awk6873/arduino-Sony_S50CP/worklog/DSC_0122.jpg

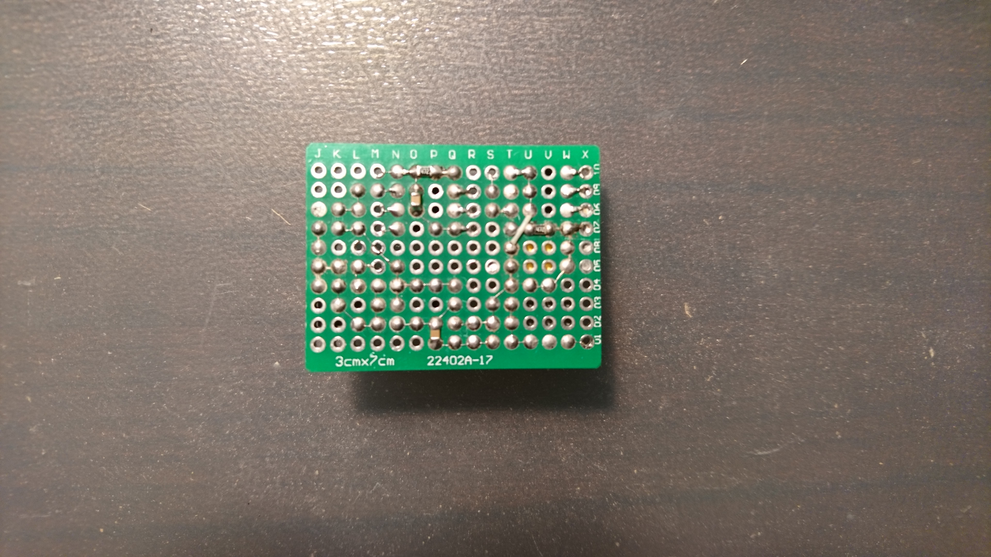
worklog/DSC_0122.jpg
