awk6873/arduino-Sony_S50CP/worklog/1zss50cp.jpg

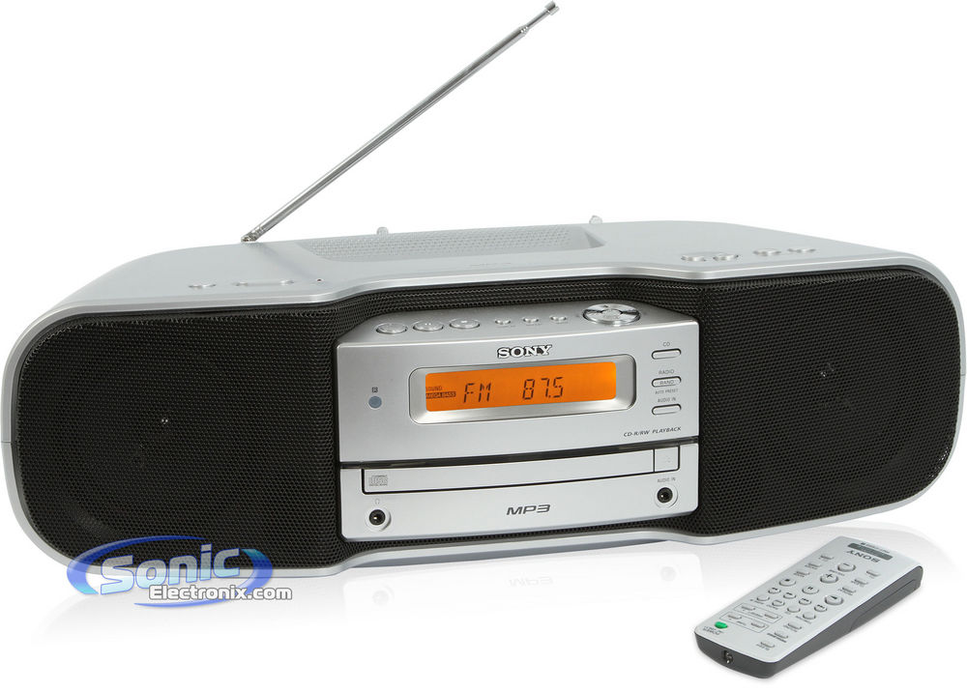
worklog/1zss50cp.jpg
