awk6873/arduino-Sony_S50CP/README.md

# arduino-Sony_S50CP

 Add-on to personal audio system Sony ZS-S50CP 
 - adding enhanced bass and treble adjustment to sound through native RC controller
 - adding bluetooth module KRC-86B to audio-in with remote control through native RC controller

Based on two ATtiny and KRC-86B BT board
