awk6873/arduino-Sony_S50CP/Datasheets/KRC86B_conn.jpg

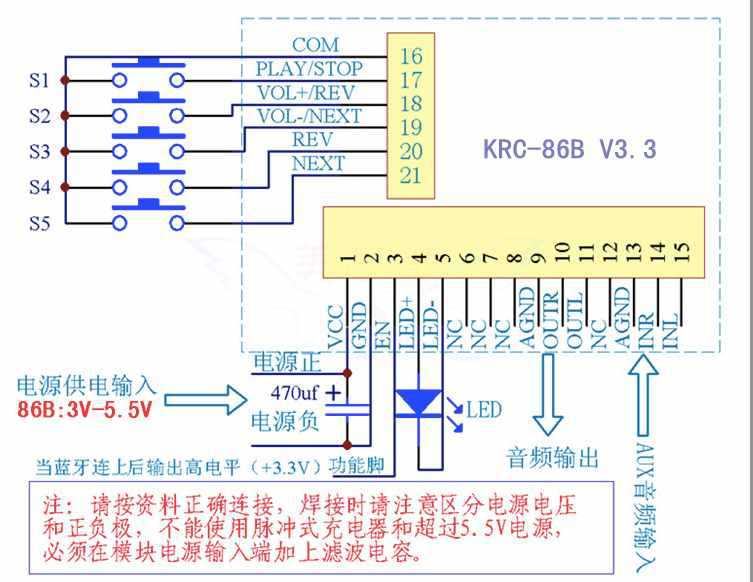
Datasheets/KRC86B_conn.jpg
