awk6873/arduino-Sony_S50CP/Datasheets/KRC86B_pinout.jpg

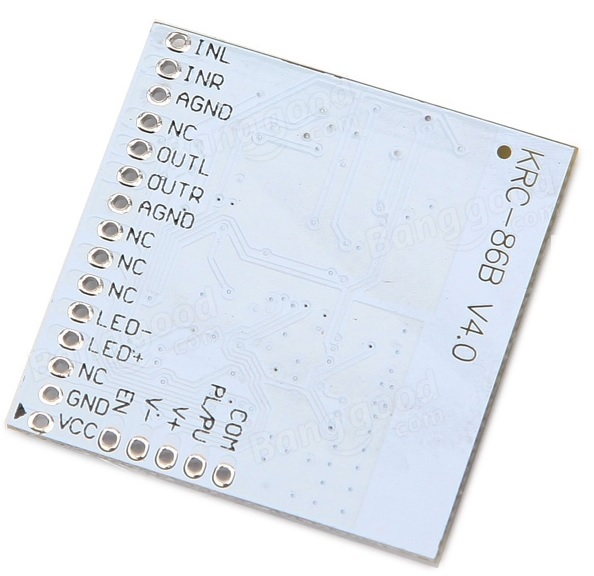
Datasheets/KRC86B_pinout.jpg
