awk6873/arduino-Sony_S50CP/Datasheets/R2S15904SP.jpg

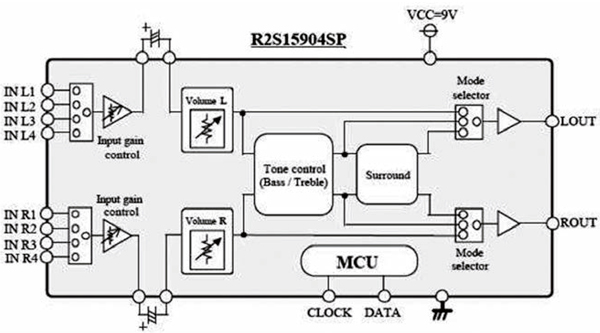
Datasheets/R2S15904SP.jpg
