awk6873/arduino-Sony_S50CP/Datasheets/R2S15904SP_pinout.jpg

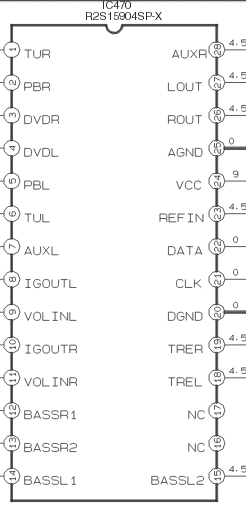
Datasheets/R2S15904SP_pinout.jpg
