awk6873/arduino-Sony_S50CP/LA_diagrams/LA_20180124_Off_1.jpg

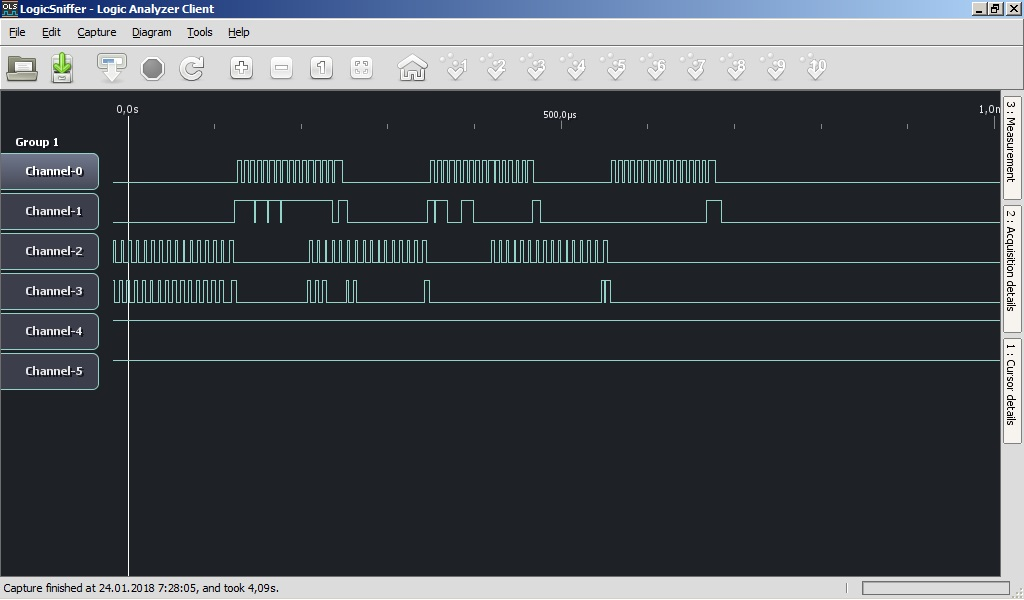
LA_diagrams/LA_20180124_Off_1.jpg
