awk6873/arduino-Sony_S50CP/LA_diagrams/LA_201801122250.jpg

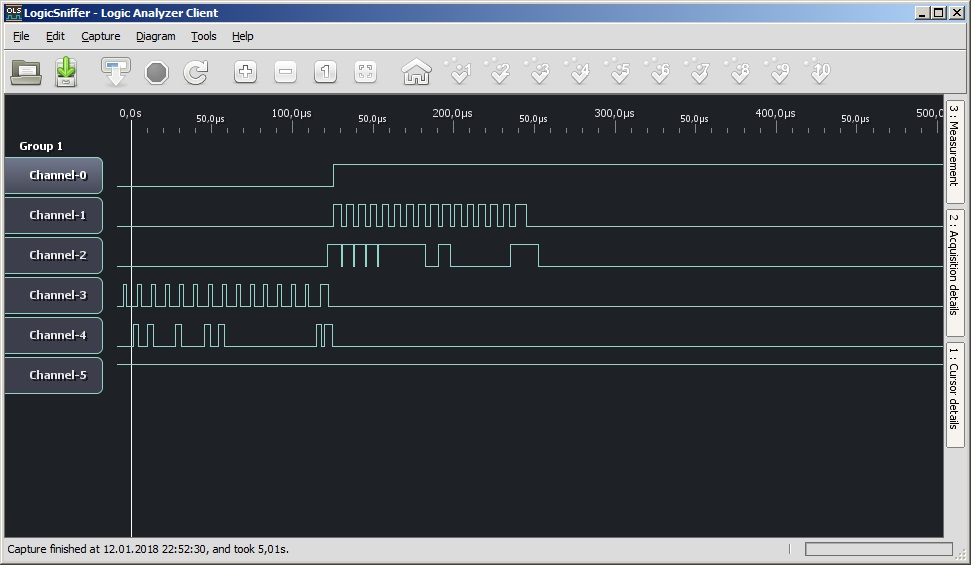
LA_diagrams/LA_201801122250.jpg
