awk6873/arduino-Sony_S50CP/LA_diagrams/LA_201801141800.jpg

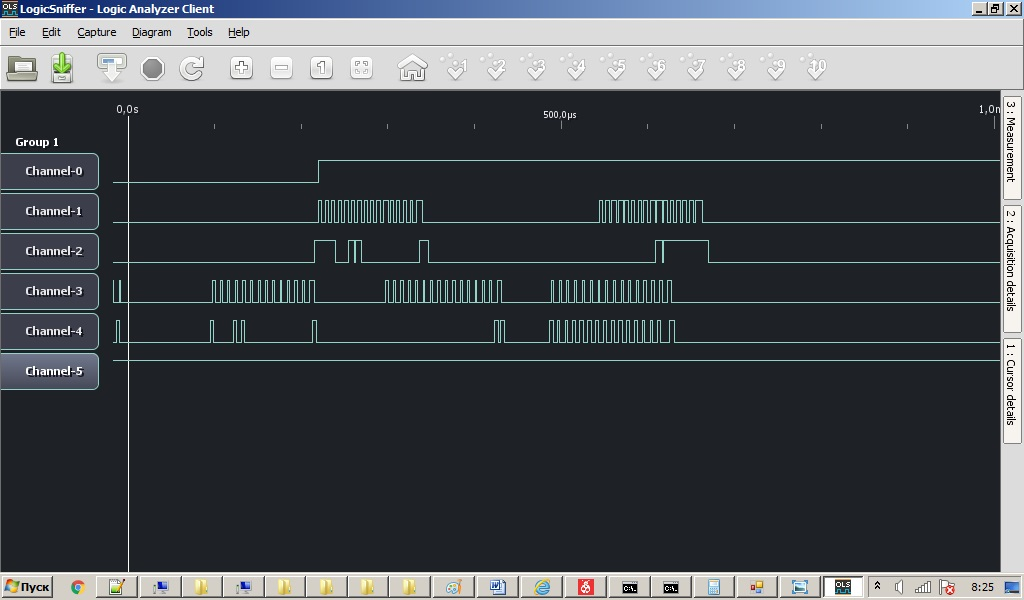
LA_diagrams/LA_201801141800.jpg
