awk6873/arduino-Sony_S50CP/Sony_RC_Play_code.jpg

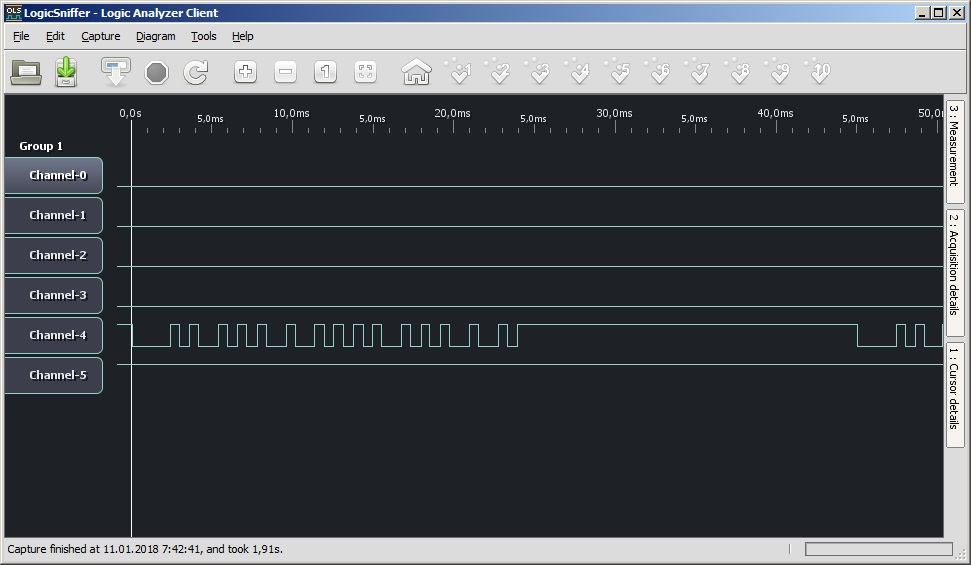
Sony_RC_Play_code.jpg
