awk6873/arduino-Sony_S50CP/Схема.jpg

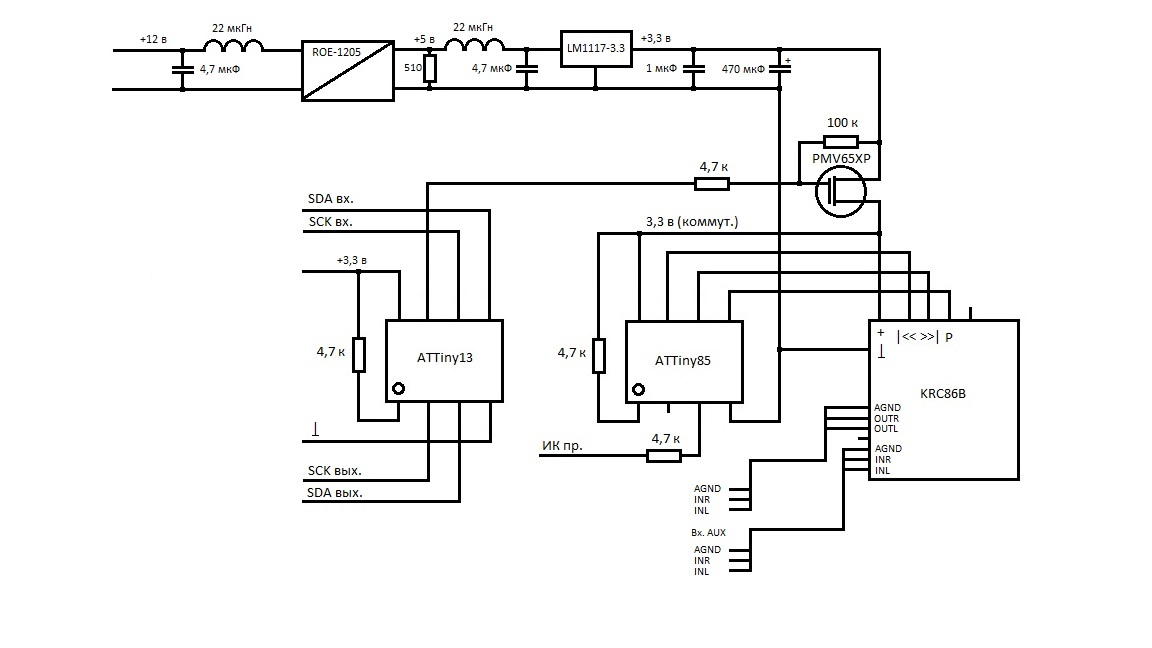
Схема.jpg
