awk6873/arduino-Sony_S50CP/Схема_v2.jpg

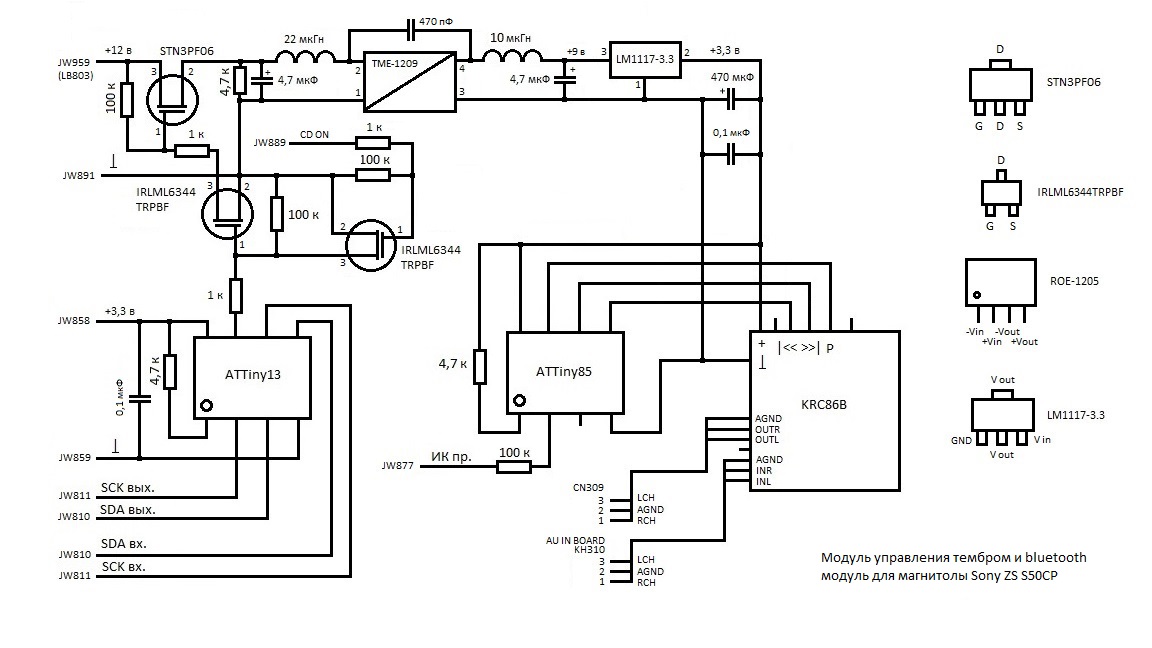
Схема_v2.jpg
