awk6873/arduino-Sony_S50CP/(list of files, cad)

Other CAD files:
Sony_S50CP_Sound.obj
Test1.obj
