awk6873/arduino-Sony_S50CP/worklog/DSC_0045.JPG

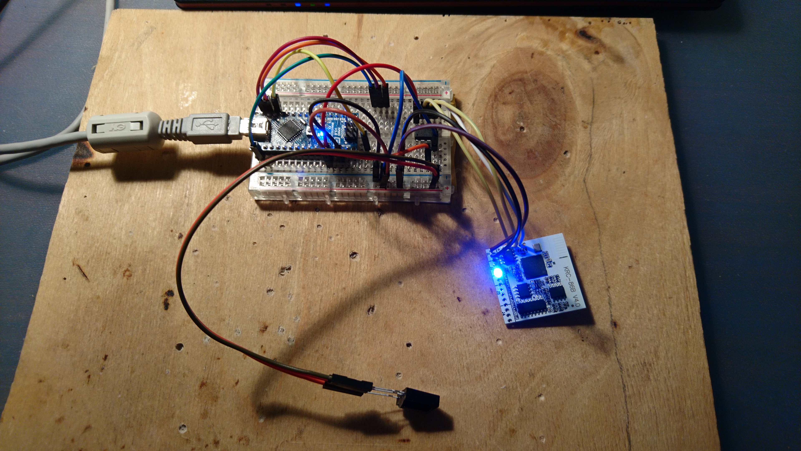
worklog/DSC_0045.JPG
