awk6873/arduino-Sony_S50CP/worklog/DSC_0117.JPG

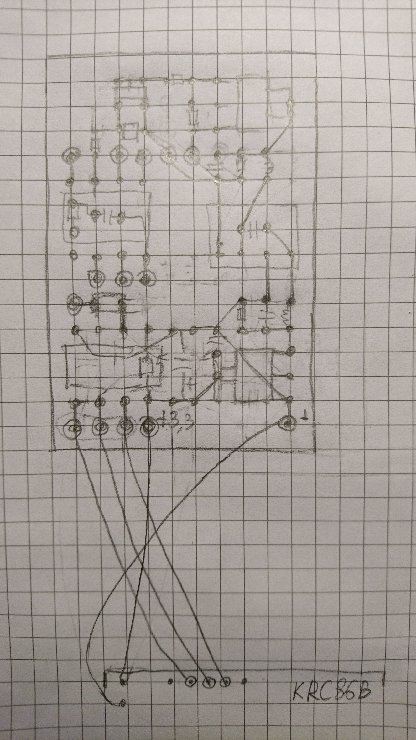
worklog/DSC_0117.JPG
