awk6873/arduino-Sony_S50CP/worklog/DSC_0249.JPG

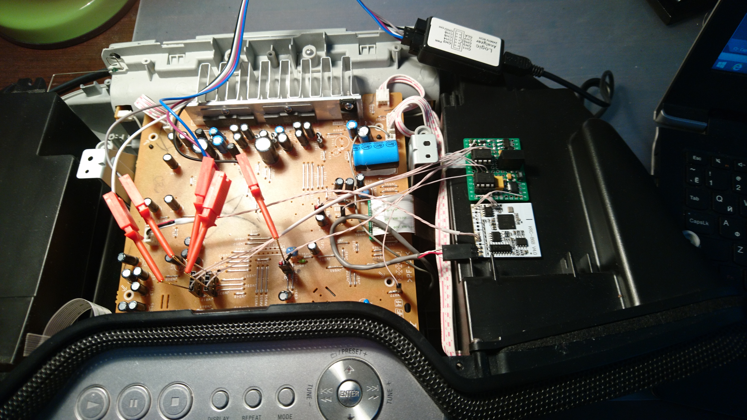
worklog/DSC_0249.JPG
