awk6873/arduino-Sony_S50CP/worklog/KRC86B.jpg

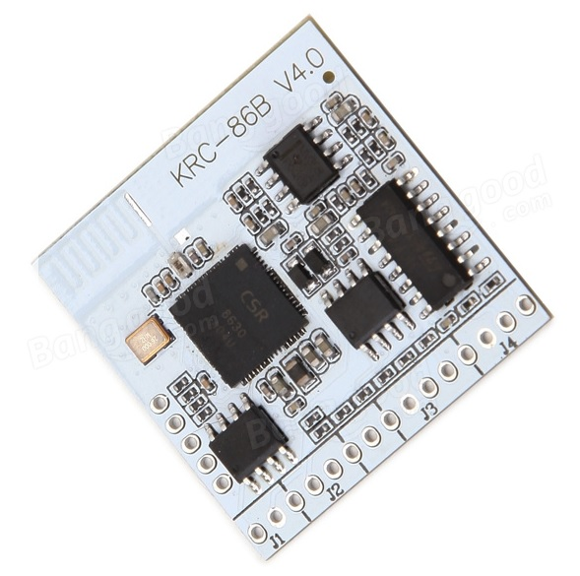
worklog/KRC86B.jpg
