awk6873/arduino-Sony_S50CP/(commit log)

2022-01-20 Load project to git
    [Sony_S50CP_Sound.obj, Test1.obj]
2022-01-20 Load new version
    [Sony_S50CP_Sound.obj]
